bendelathouwer/KicadLibs/(commit log)

2020-04-29 modules toegevoegd
    schematic lib voor modulles toegevoegd
2020-04-29 RC connector
    rc connector toegevoegd
2020-04-30 symbool
    symbool aangepast zodat het schema beter uitkwam
2020-10-28 footprint
    footprints toegevoegd
2020-11-05 Solide state relay
    solide state relay toegevoegd
2020-11-09 vanalles
    verder gewerkt aan de schemasymbolen
2020-11-09 power_user
    user power lib toegevoegd
2020-11-10 footprints
    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
2020-11-12 vanalles
    vanalle kicad libs bijgewerkt
2020-11-27 battery connectors
    xt60 toegevoegd
2020-12-08 footprints
    connector + footprint jtag conntector
2021-01-20 footprints+libs
    verschilende footprints + libary's toegevoegd
2021-03-13 cleanup
    footprint libary cleanup
2021-04-06 footprints
    footprints etc opgekuist
2021-04-12 gecenterd
    alle componenten zijn gecenterd voor de CPL file juist te hebben
2021-04-12 update
    motordriver symbool geupdate
2021-05-21 testpad
    testpad footprints toegevoegd
2021-05-21 Update crystal tht.kicad_mod
2021-05-31 stm32l5 toegevoegd
2022-05-27 Create 8 so.kicad_mod
2025-04-20 Revert "Update vanalles.kicad_sym"
    This reverts commit 4fc64bedebc264d4015cd61c7d25c283b193f9fd.
